Skydive/part-iii-thesis/src/accel_soc_fw/src/libc.h

#pragma once
#include <stdint.h>

#include "mem_map.h"
#include "ns16550.h"

// Printing type conversion
void itoa(int n, char* s, int len, int base)
{
  int i, sign;

  if ((sign = n) < 0)  /* record sign */
    n = -n;           /* make n positive */
  i = 0;
  do {  /* generate digits in reverse order */
    int x = n % base;
    s[i++] = x + ((x < 10) ? '0' : ('A'-10));  /* get next digit */
  } while ((n /= base) > 0);   /* delete it */
  if (sign < 0)
    s[i++] = '-';
  s[i] = '\0';

  for(int j=0; j<(i>>2 - 1); j++) {
    char tmp = s[j];
    s[j] = s[i-1-j];
    s[i-1-j] = tmp;
  }
}

void utoa(uint32_t n, char* s, int len, int base)
{
  int i;

  i = 0;
  do {  /* generate digits in reverse order */
    int x = n % base;
    s[i++] = x + ((x < 10) ? '0' : ('A'-10));  /* get next digit */
  } while ((n /= base) > 0);   /* delete it */
  s[i] = '\0';

  for(int j=0; j<(i>>2 - 1); j++) {
    char tmp = s[j];
    s[j] = s[i-1-j];
    s[i-1-j] = tmp;
  }
}



int intToStr(int x, char str[], int d) 
{ 
  int i = 0; 
  while (x) { 
    str[i++] = (x % 10) + '0'; 
    x = x / 10; 
  } 
  
  // If number of digits required is more, then 
  // add 0s at the beginning 
  while (i < d) 
    str[i++] = '0'; 
  
  for(int j=0; j<(i>>2 - 1); j++) {
    char tmp = str[j];
    str[j] = str[i-1-j];
    str[i-1-j] = tmp;
  }

  str[i] = '\0'; 
  return i; 
} 

void ftoa(float n, char* res, int afterpoint)
{
  int ipart = (int)n;

  float fpart = n - (float)ipart;
  int i = intToStr(ipart, res, 0);

  if (afterpoint != 0) {
    res[i] = '.'; // add dot

    fpart = fpart * pow(10, afterpoint);

    intToStr((int)fpart, res + i + 1, afterpoint);
  }
}

// PRINTING

void _putchar(char c)
{
	struct device_t dev;
	dev.addr = NS16550_ADDR;
  vOutNS16550(&dev, c);
}

void print(const char* str){
	struct device_t dev;
	dev.addr = NS16550_ADDR;
	while(*str){
		vOutNS16550(&dev, *str);
		str++;
	}
}


void println(const char* str){
	struct device_t dev;
	dev.addr = NS16550_ADDR;
	print(str);
	vOutNS16550( &dev, '\n' );
}

void delay(uint32_t loops){
	for(int i=0;i<loops;i++){
		asm volatile("nop");
	}
}
void print_slow(const char* str){
	struct device_t dev;
	dev.addr = NS16550_ADDR;
	while(*str){
		vOutNS16550(&dev, *str);
		//delay(1000UL);
		str++;
	}
}
