Skydive/part-iii-thesis/src/accel_soc_fw/src/ns16550.h

/*
 * FreeRTOS V202012.00
 * Copyright (C) 2020 Amazon.com, Inc. or its affiliates.  All Rights Reserved.
 *
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
 * https://www.FreeRTOS.org
 * https://www.github.com/FreeRTOS
 *
 * 1 tab == 4 spaces!
 */

#ifndef NS16550_H_
#define NS16550_H_

#include <stdint.h>

struct device_t {
	uintptr_t addr;
};

void vOutNS16550( struct device_t *dev, unsigned char c );

#endif /* NS16550_H_ */
